LuisPinto-Electronics/Maze-Solving-Robot-V1.0/images/3D.png

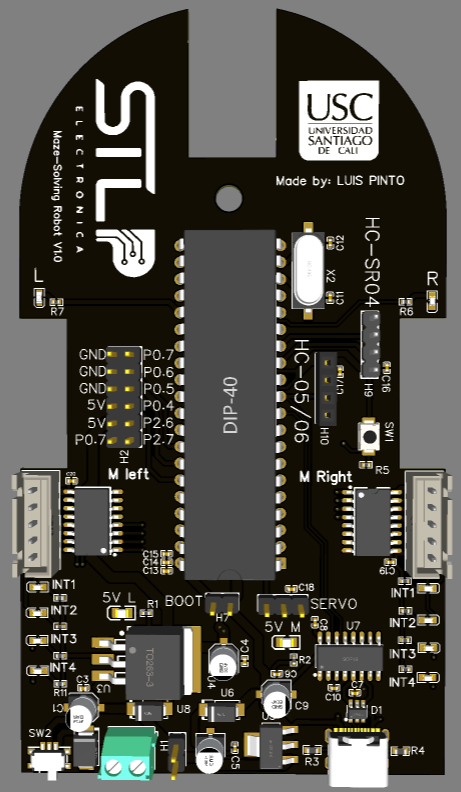
images/3D.png
