LuisPinto-Electronics/Maze-Solving-Robot-V1.0/BOM_Maze-Solving-Robot_2026-09-13.csv

ID | Name | Designator | Footprint | Quantity | Manufacturer Part | Manufacturer | Supplier | Supplier Part | Price | JLCPCB Part Class
1 | TS-1088-AR02016 | SW1 | SW-SMD_L3.9-W3.0-P4.45 | 1 | TS-1088-AR02016 | XUNPU(讯普) | LCSC | C720477 | 0.053 | Basic Part
2 | MINI MSK12CO2 | SW2 | SW-SMD_MSK12CO2 | 1 | MINI MSK12CO2 | SHOU HAN(首韩) | LCSC | C2681570 | 0.173 | Extended Part
3 | DB301V-3.5-2P-GN | U1 | CONN-TH_DB301V-3.5-2P-GN | 1 | DB301V-3.5-2P-GN-S | DORABO(地博电气) | LCSC | C695629 | 0.103 | Extended Part
4 | SL22-E3/52T | D2 | SMB_L4.6-W3.6-LS5.3-RD | 1 | SL22-E3/52T | VISHAY(威世) | LCSC | C142616 | 0.675 | Extended Part
5 | YLED0603B | LED5,LED6,LED7,LED8,LED9,LED10,LED11,LED12,LED3 | LED0603-FD | 9 | YLED0603B | YONGYUTAI(永裕泰) | LCSC | C19171394 | 0.006 | Extended Part
6 | PZ254V-11-02P | H7,H1 | HDR-TH_2P-P2.54-V-M | 2 | PZ254V-11-02P | XFCN(兴飞) | LCSC | C492401 | 0.018 | Extended Part
7 | HX PH254-01-03-Z-L11.5 PCB PIN HEADER | H8 | HDR-TH_3P-P2.54-V-M-1 | 1 | HX PH254-01-03-Z-L11.5 pcb pin header | hanxia(韩下) | LCSC | C52016391 | 0.024 | Extended Part
8 | HX PH254-01-04-Z-L11.5 STRAIGHT PIN HEADER | H9 | HDR-TH_4P-HX-PH254-01-04-Z-L11.5 | 1 | HX PH254-01-04-Z-L11.5 straight pin header | hanxia(韩下) | LCSC | C52016392 | 0.033 | Extended Part
9 | 2.54-1*4P母 | H10 | HDR-TH_4P-P2.54-V-F | 1 | 2.54-1*4P母 | BOOMELE(博穆精密) | LCSC | C2718488 | 0.079 | Extended Part
10 | 10uF | C1,C2,C9 | CAP-SMD_BD4.0-L4.3-W4.3-FD | 3 | EEEHP1A100R | PANASONIC(松下) | LCSC | C401860 | 0.223 | Extended Part
11 | 100nF | C3,C4,C5,C6,C7,C8,C10,C13,C14,C15,C16,C17,C18,C19,C20 | C0402 | 15 | CL05A104KP5NNNC | SAMSUNG(三星) | LCSC | C159815 | 0.006 | Extended Part
12 | 33pF | C11,C12 | C0402 | 2 | CL05C330JB5NNNC | SAMSUNG(三星) | LCSC | C70465 | 0.004 | Extended Part
13 | USBLC6-2SC6 | D1 | SOT-23-6_L2.9-W1.6-P0.95-LS2.8-BL | 1 | USBLC6-2SC6 | ST(意法半导体) | LCSC | C7519 | 0.184 | Extended Part
14 | PZ254V-12-12P | H2 | HDR-TH_12P-P2.54-V-M-R2-C6-S2.54 | 1 | PZ254V-12-12P | XFCN(兴飞) | LCSC | C492423 | 0.077 | Extended Part
15 | FC-2012UGK-520D5 | LED2,LED1 | LED0805-R-RD | 2 | NCD0805G1 | 国星光电 | LCSC | C84260 | 0.023 | Extended Part
16 | YLED0603Y | LED4 | LED0603-RD-1 | 1 | YLED0603Y | YONGYUTAI(永裕泰) | LCSC | C19273152 | 0.007 | Extended Part
17 | 220Ω | R1,R2,R6,R7,R8,R9,R10,R11,R12,R13,R14,R15 | R0402 | 12 | MCS04020C2200FE000 | VISHAY(威世) | LCSC | C2074289 | 0.04 | Extended Part
18 | 10kΩ | R5 | R0402 | 1 | RC0402FR-0710KL | YAGEO(国巨) | LCSC | C60490 | 0.003 | Extended Part
19 | 5.1kΩ | R3,R4 | R0603 | 2 | FRC0603F5101TS | FOJAN(富捷) | LCSC | C2907044 | 0.002 | Extended Part
20 | ULN2003ANSR | U2,U12 | SO-16_L10.2-W5.3-P1.27-LS7.8-BL | 2 | ULN2003ANSR | TI(德州仪器) | LCSC | C2869104 | 0.903 | Extended Part
21 | LM1085IS-5.0RG | U3 | TO-263-3_L8.6-W10.2-P2.54-LS14.4-BR | 1 | LM1085IS-5.0RG | HGC(深圳汉芯) | LCSC | C5145336 | 0.301 | Extended Part
22 | 22uF | U4 | CAP-SMD_BD4.0-L4.3-W4.3-LS5.0-FD | 1 | RVT1A220M0405 22UF 10V | DMBJ(振宝佳) | LCSC | C970661 | 0.029 | Extended Part
23 | 1N4002 | U6,U8 | SMA_L4.3-W2.7-LS5.1-RD | 2 | 1N4002 | DOWO(东沃) | LCSC | C20624758 | 0.008 | Extended Part
24 | CH340C | U7 | SOP-16_L10.0-W3.9-P1.27-LS6.0-BL | 1 | CH340C | WCH(南京沁恒) | LCSC | C84681 | 0.59 | Extended Part
25 | STC89C52RC-40I | U9 | DIP-40_L52.0-W13.7-P2.54-LS15.2-BL | 1 | STC89C52RC-40I-PDIP40 | STC | LCSC | C14022 | 1.616 | Extended Part
26 | XH-5PA | U10,U11 | CONN-TH_5P-P2.50_ZHOURI_XH-5PA | 2 | XH-5PA | ZHOURI(洲日) | LCSC | C5258886 | 0.018 | Extended Part
27 | TYPE-C 16P(073) | USB1 | USB-C-SMD_TYPE-C16PIN_C668624 | 1 | TYPE-C 16P(073) | SHOU HAN(首韩) | LCSC | C668624 | 0.099 | Extended Part
28 | 12MHz | X2 | HC-49S_L11.4-W4.8 | 1 | X49SM12MSD2SC | YXC(扬兴晶振) | LCSC | C14871 | 0.111 | Extended Part
29 | LM7805MPX/NOPB | U5 | SOT-223-4_L6.5-W3.5-P2.30-LS7.0-BR | 1 | LM7805MPX/NOPB | TI(德州仪器) | LCSC | C2848241 | 1.195 | Extended Part
