LuisPinto-Electronics/Maze-Solving-Robot-V1.0/(list of files, cad)

Other CAD files:
Maze-solving-robot-CODE/Objects/main.obj
Maze-solving-robot-CODE/Objects/MazeSolving.obj
Maze-solving-robot-CODE/Objects/HCSR04.obj
Maze-solving-robot-CODE/Objects/servo.obj
Maze-solving-robot-CODE/Objects/BYJ48.obj
Maze-solving-robot-CODE/Objects/delay.obj
Maze-solving-robot-CODE/Objects/STARTUP.obj
Maze-solving-robot-CODE/Objects/UART.obj
