LuisPinto-Electronics/Maze-Solving-Robot-V1.0/Schematic_Maze-Solving-Robot_2026-09-14.pdf

# Power Supply STC89C52RC

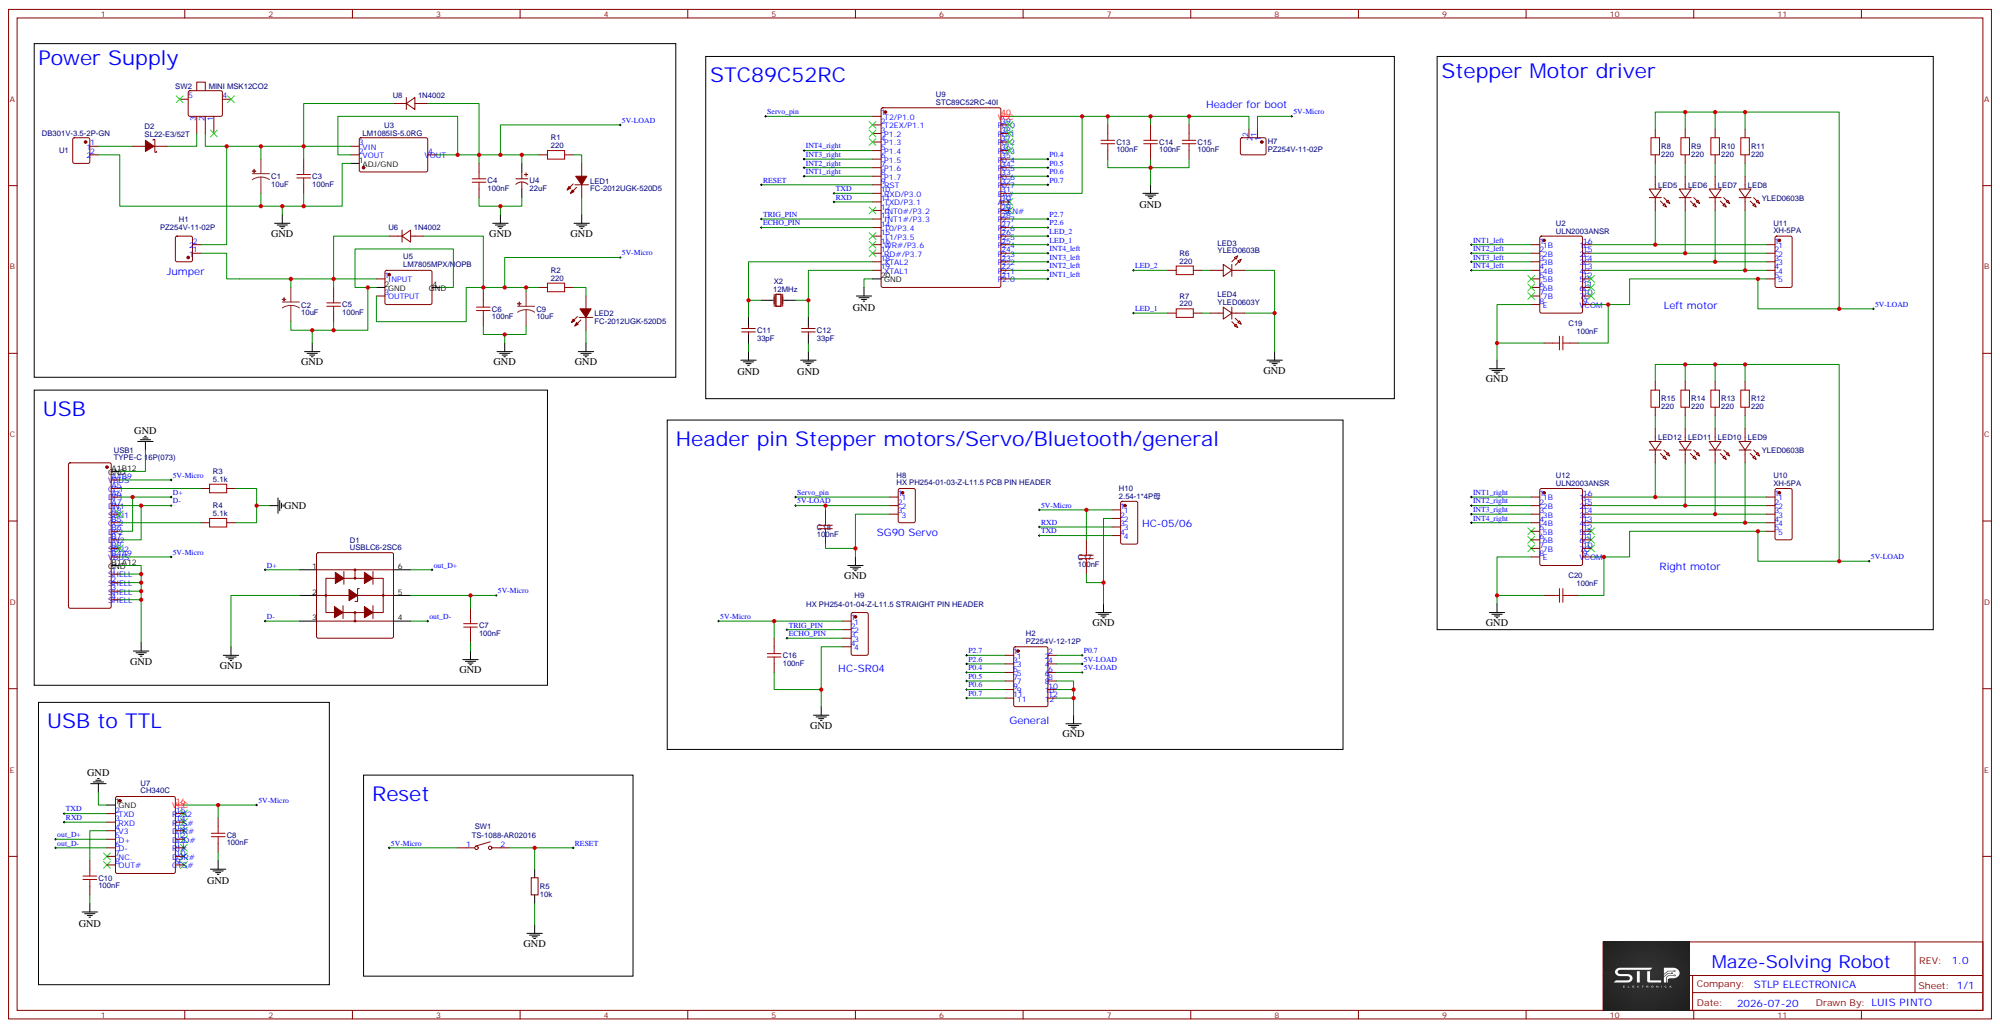
[picture p12: page 1]

GND
GND B1A12 VBUS B4A9 SBU2 B8 DN2 B7 DP2 B6 CC2 B5 SBU1 A8 DN1 A7 DP1 A6 CC1 A5 VBUS A4B9 GND A1B12

Header pin Stepper motors/Servo/Bluetooth/general

HX PH254-01-04-Z-L11.5 STRAIGHT PIN HEADER

Drawn By: LUIS PINTO
